Vitech-UA/Freq-invertor-MC3PHAC/Фото. Фільтр для частотника.jpg

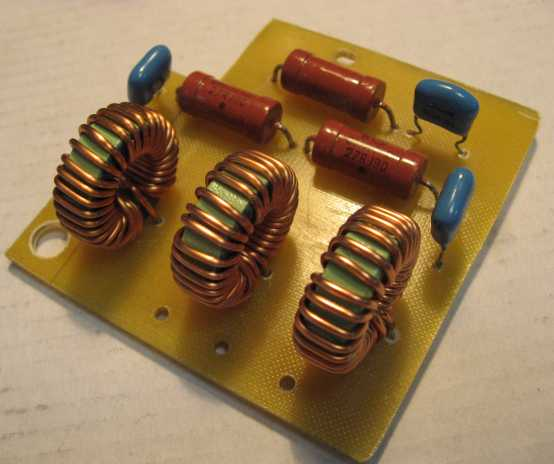
Фото. Фільтр для частотника.jpg
