Vitech-UA/Freq-invertor-MC3PHAC/README.md

# Зібраний екземпляр
