Vitech-UA/Freq-invertor-MC3PHAC/Робочий варіант/Тормозной модуль.pdf

Тормозной модуль

Контроллер MC3PHAC позволяет реализовать резистивное торможение. При превышении напряжения ЗПТ на 10% от номинального значения (при торможении двигатель начинает работать в генераторном режиме, генерируемая энергия накапливается на конденсаторе ЗПТ) контроллер будет подавать ШИМ с несущей частотой f

br ШИМ = 5 кГц на пин RBRAKE. Для реализации торможения необходимо

использовать транзистор, который будет работать в ключевом режиме и «сливать» заряд с конденсатора ЗПТ через тормозной резистор. Такая схема показана на рисунке 3.34.

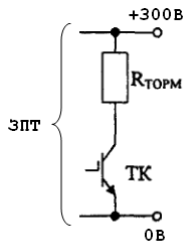
[picture p7: figure]

Рисунок 3.34 – Схема резистивного торможения

Тормозное сопротивление рассчитаем по [92], [55, с. 54], [48, с. 476].

Максимальное ускорение при торможении:

1 2
2
6000 0 | об
3000
2 | с br

n n
a
t
= | = | = | ,

где 1

n ,
2

n – частота вращения вала двигателя в начале и в конце торможения, об/мин;
br t – время торможения, с.

Такое ускорение торможения в данном случае допустимо по нормам механики двигателя и исполнительного механизма (
доп

a a ≤ ), а также может быть обеспечено

контроллером MC3PHAC (поддерживает ускорение до 127 Гц). Максимальное угловое ускорение при торможении:

max | 2
2 | 2 3,142 | рад
3000 | 314,159
60 | 60 | с
br | a

π
ε

·
= · | = | · | = | .

Динамический момент при торможении:

д M | J = Σ
·ε = 0,0061 314,159 1,916 · | = | Н ·м ,

где JΣ
– суммарный момент инерции, приведенный к валу двигателя,

2

кг ·м ; примем
2
дв
J | J Σ = 8 | 8 0,00076 0,0061 · | = · | = | кг ·м .

Максимальный тормозной момент:

max | д | с M | M | M br | = | - | =1,916 1,284 0,632 - | = | Н ·м,

где Mс
– статический рабочий момент сопротивления; примем равным номинальному моменту:
с | н M | M= | =1,284 Н ·м .

Максимальная мощность при торможении:

1
max | max
2 | 2 6000 0,632 | 397 Вт
60 | 60 br | br

n

P | M | π · | π ·
= | · | = | · | = | .

Коэффициент уменьшения для генераторного режима [55, табл. 1] выберем по таблице 2:

k = 0,25.

Таблица 2 – Таблица выбор коэффициента уменьшения мощности

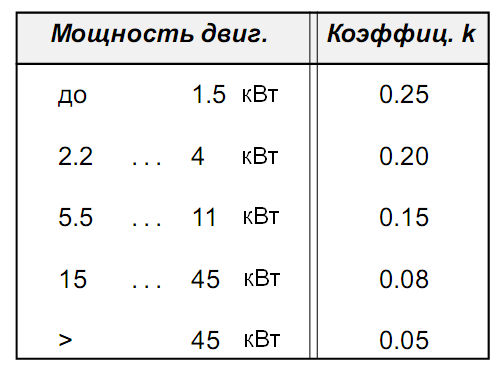
[picture p8: figure]

Электрическая мощность торможения (если < 0, значит энергия в привод не возвращается и тормозной модуль не нужен) :

электр | max | ном
397 0,25 370 305 Вт P | P | k P = br | - · | = | - | · | = | .

Омическое сопротивление тормозного модуля:

2 | 2

электр

340 379 Ом
305

br
br

U
R
P
< | = | < | ,

где Ubr – напряжение срабатывания торможения, В;
для MC3PHAC | ЗПТном U | U br =1,1 | 309 1,1 340 · | = | · = | В.

Из стандартных выбираем Rbr = 300 Ом . Тогда электрическая мощность

пересчитается:

2 | 2

электр

340 385,333 Вт
300

Ubr P
R
= | = | = | .

Время рабочего цикла 5 минут. По [55] для ц

t >120 с принимаем время

рабочего цикла:

ц

t =120 с .

Продолжительность включения тормозного модуля:

ц

2
ПВ | 100% | 100% 1,67%
120

br
br

t
t
= · | = | · | =

По графику [55, рис. 51] определяют константу к

| | | f . Этот график приведен на
рисунке 3.35.

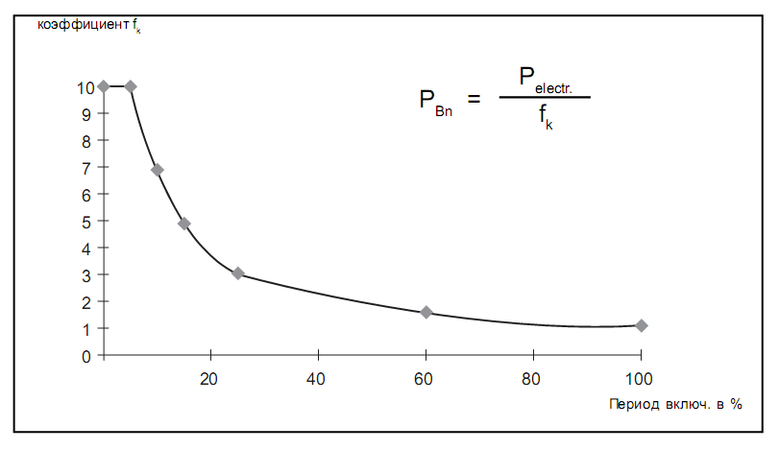
[picture p9: figure]

Рисунок 3.35 –Зависимость константы к

f от ПВ тормозного резистора

По графику на рисунке 3.35 определится константа к

f :

к

f =10.

Номинальная мощность теплового рассеяния тормозного резистора:

электр

к

385,333 38,5 Вт

10 Rbr

P
P
f
= | = | = | .

Тормозной резистор рассчитан; его сопротивление Rbr = 300 Ом , а
номинальная мощность теплового рассеяния | 38,5 Вт PRbr = | .

Стоит также заметить, что существует рекуперативное торможение с отдачей энергии торможения в сеть. Для этого применяется управляемый выпрямитель и модуль рекуперативного торможения. Но практика и расчеты показывают, что экономическая выгода таких систем торможения появляется при мощностях двигателей от 30…50 кВт.

Расчет тормозного сопротивления приведен для критических моментов торможения с довольно большой инерцией приводимого механизма. Поэтому в схеме примем резистор R77 доступной мощности 20 Вт на сопротивление 510 Ом. Схема тормозного модуля показана на рисунке 3.36.
Выберем транзистор тормозного модуля.
Ток торможения:

элект

I | P | U br | br = | = 385,333 340 1,133 = | А .

Превышение напряжение может достигать:

ЗПТкр U = 400 В.

Выберем транзистор по току и напряжению, на частоту

max | рег
f | f | u br | br = ШИМ
- 2 | 5000 2 100 1 · | = | · · | = МГц ,

где рег

u – макс. глубина регулирования; для минимальной скважности

ШИМ | ШИМmin
γ br | =1% глубина регулирования:

рег

1
100
1% 100%
u = | = | .

Таким требованиям удовлетворяет MOSFET-транзистор IRFP460.

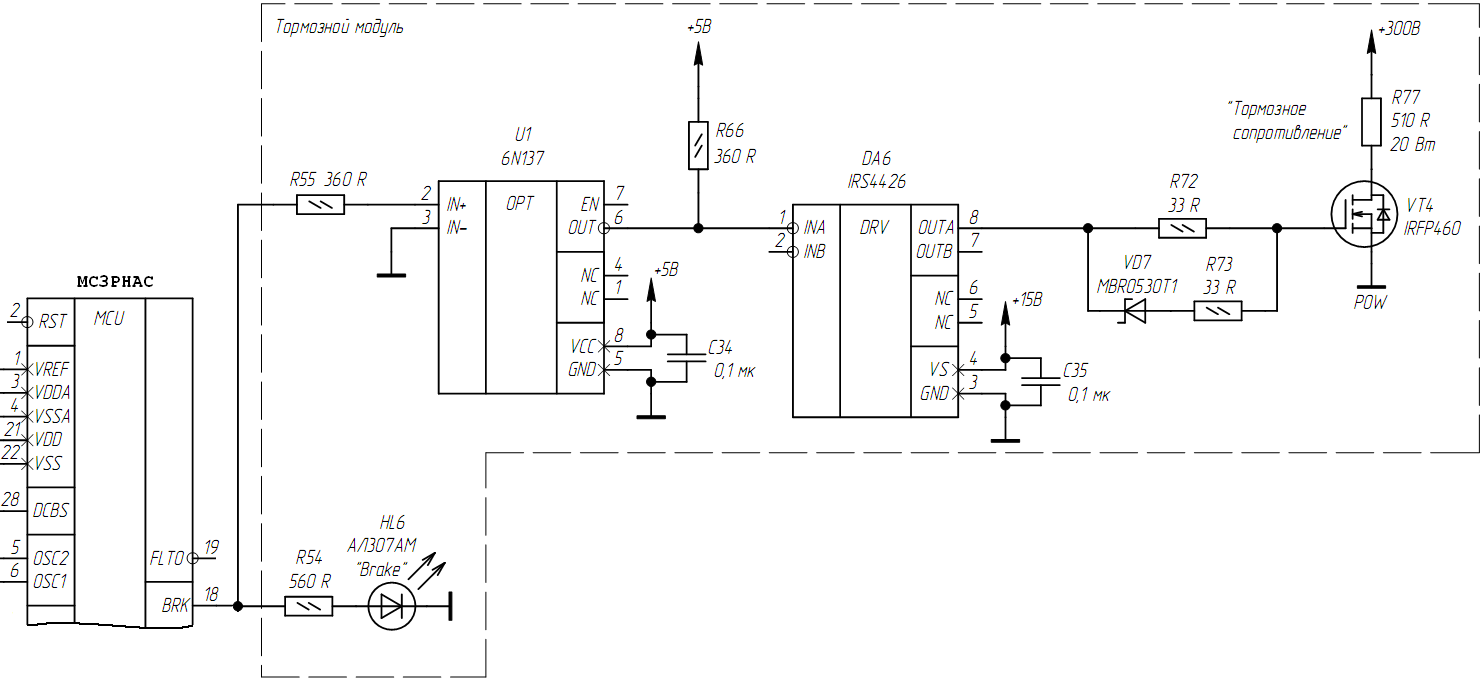
[picture p10: figure]

Рисунок 3.36 – Схема тормозного модуля

Для открытия транзистора на его затвор необходимо подать 15 В. В силу построения по КМОП-технолонии контроллер MC3PHAC работает при напряжении 5 В, соответственно амплитуда ШИМ напряжения торможения будет тоже 5 В. Для преобразования уровня напряжения применим драйвер нижних ключей IRS4426. Для быстрого закрытия транзистора в цепь затвора поставим резистор, шунтированный высокоскоростным диодом (в данном случае применен диод Шоттки MBR0530T1) – цепочка R72-VD7-R73.
Чтобы защитить пин торможения контроллера применим оптрон 6N137.
Номинальный ток передатчика-диода 6 137 I N | =10 мА . При таком токе прямое падение
напряжение составит | 6 137 ΔU N | =1,4 В. Тогда при питании от контроллера 5 В

необходим ограничивающий резистор сопротивлением

пит | 6 137
55 | 3
6 137

5 1,4 360 Ом
10 10

N

N

U U R
I

- Δ | -
= | = | =
·

Сопротивление нагрузки R66 выберем по графикам в паспорте на этот оптрон на максимальную скорость работы:

66 R = 360 Ом.

Также применена индикация торможения на светодиоде HL6. В зависимости от скважности ШИМ светодиод будет гореть с разной яркостью, по которой можно судить о процессе торможения.
