Vitech-UA/Freq-invertor-MC3PHAC/element/схема.gif

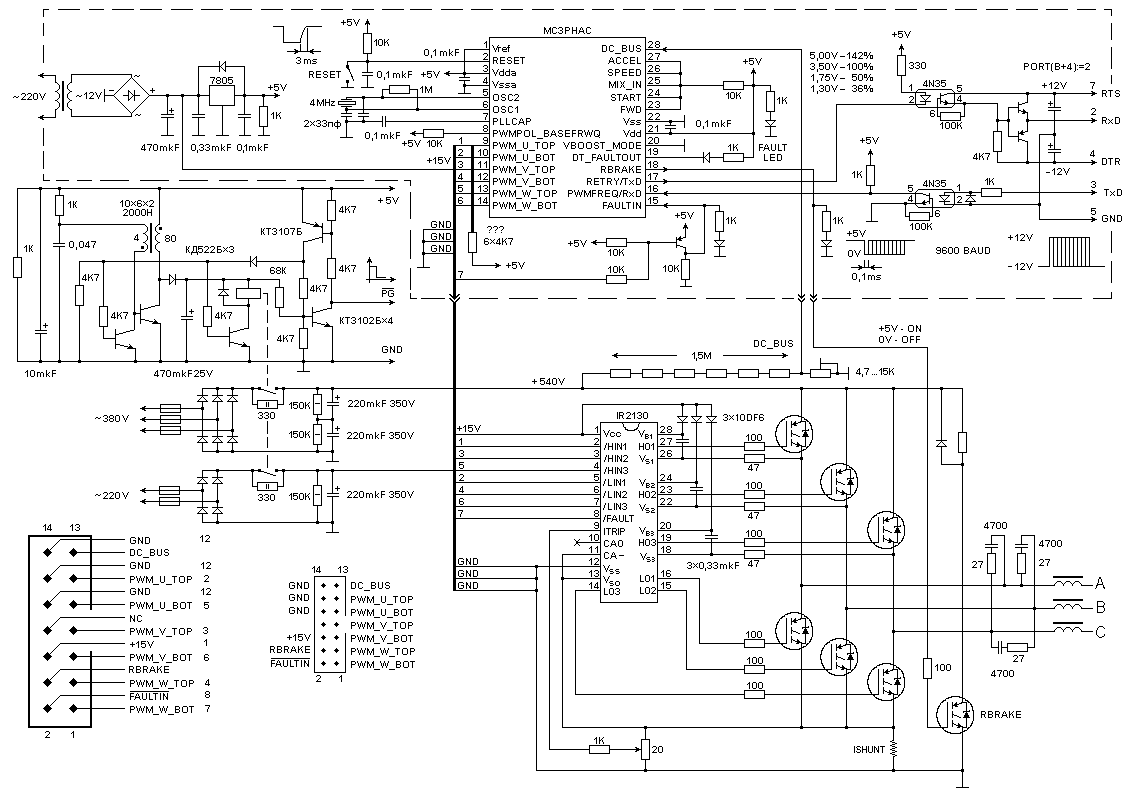
element/схема.gif
