Vitech-UA/Freq-invertor-MC3PHAC/element/ТПЧ.gif

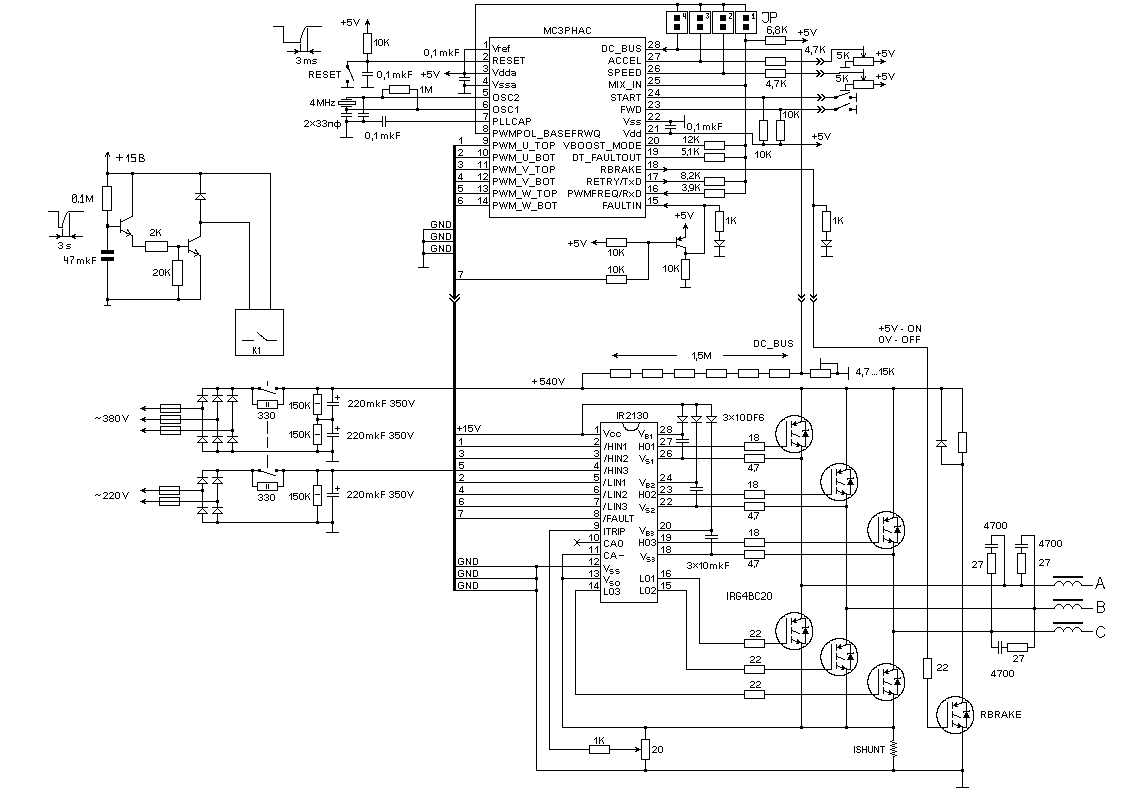
element/ТПЧ.gif
