Vitech-UA/Freq-invertor-MC3PHAC/pcb-shematic/circuit_b.gif

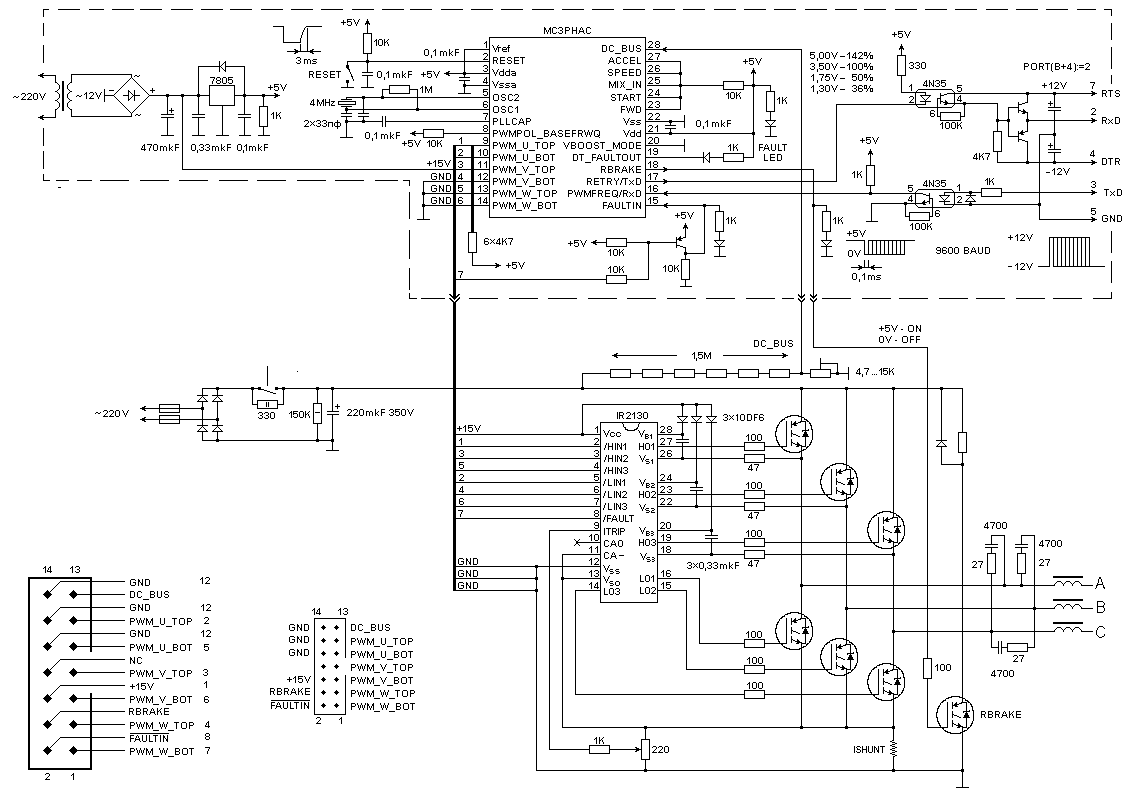
pcb-shematic/circuit_b.gif
