Vitech-UA/Freq-invertor-MC3PHAC/Версія 1/VER 2.1 plata.JPG

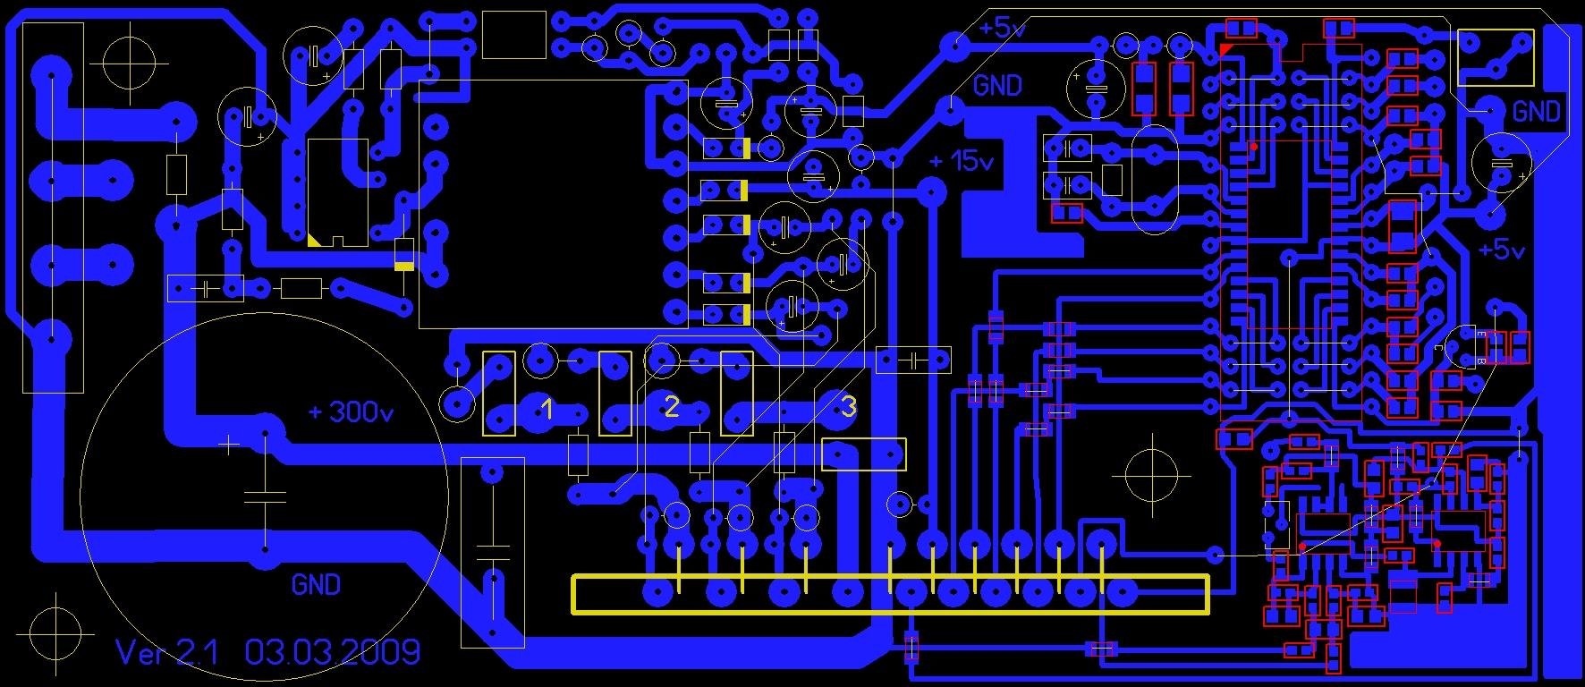
Версія 1/VER 2.1 plata.JPG
