Vitech-UA/Freq-invertor-MC3PHAC/Версія 1/VER 2.1 shema.JPG

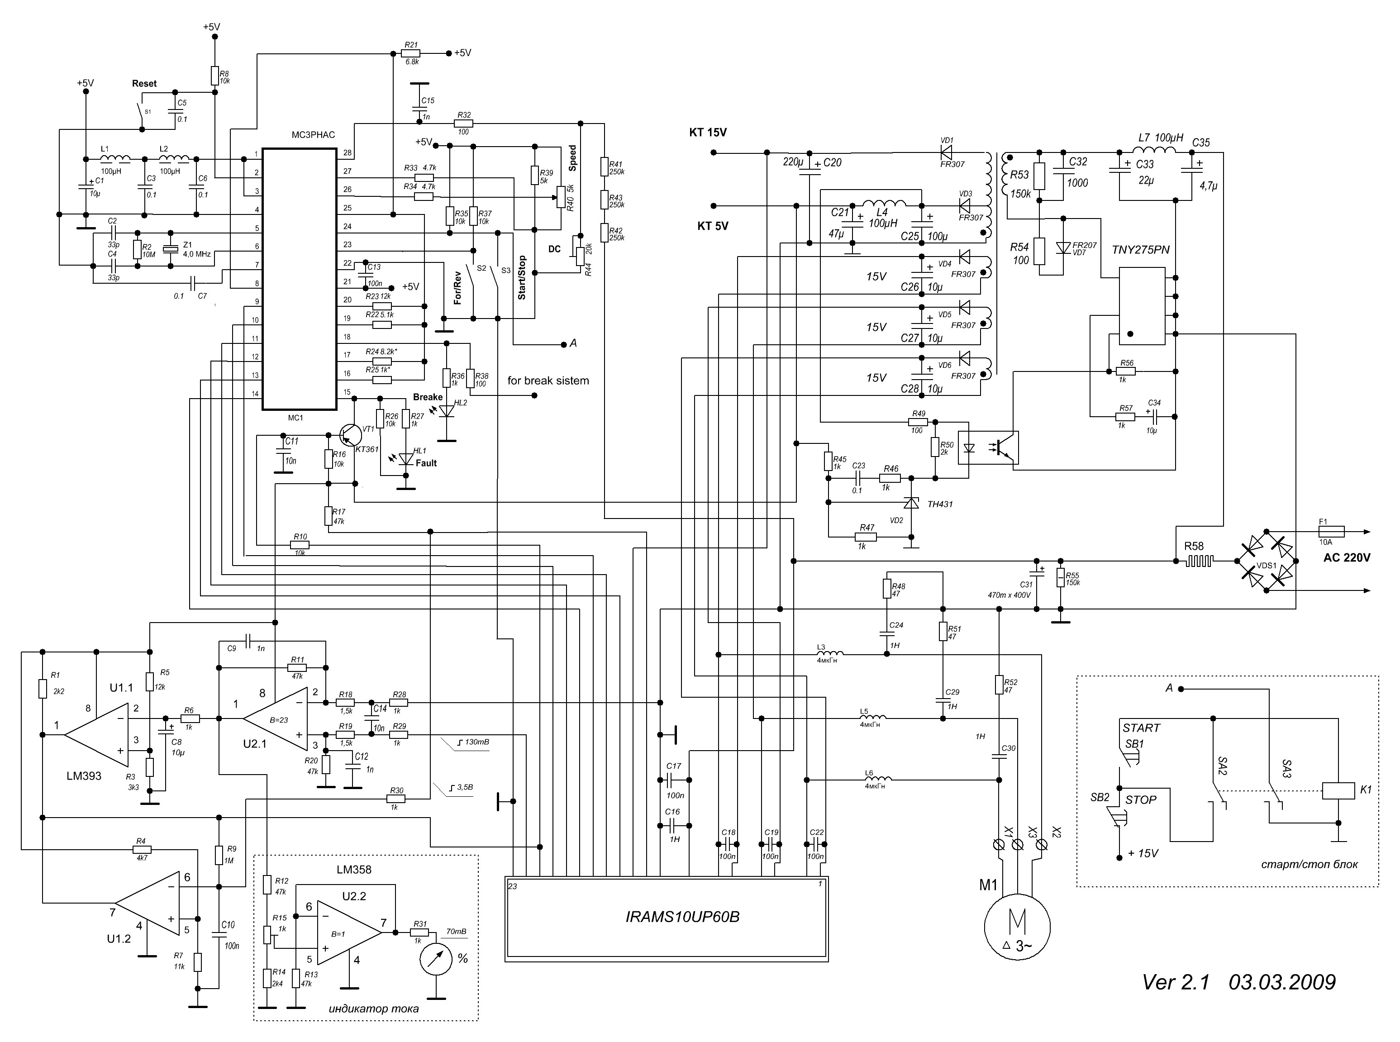
Версія 1/VER 2.1 shema.JPG
