Vitech-UA/Freq-invertor-MC3PHAC/Робочий варіант/П.З/Лист задания на д.п/02.tif

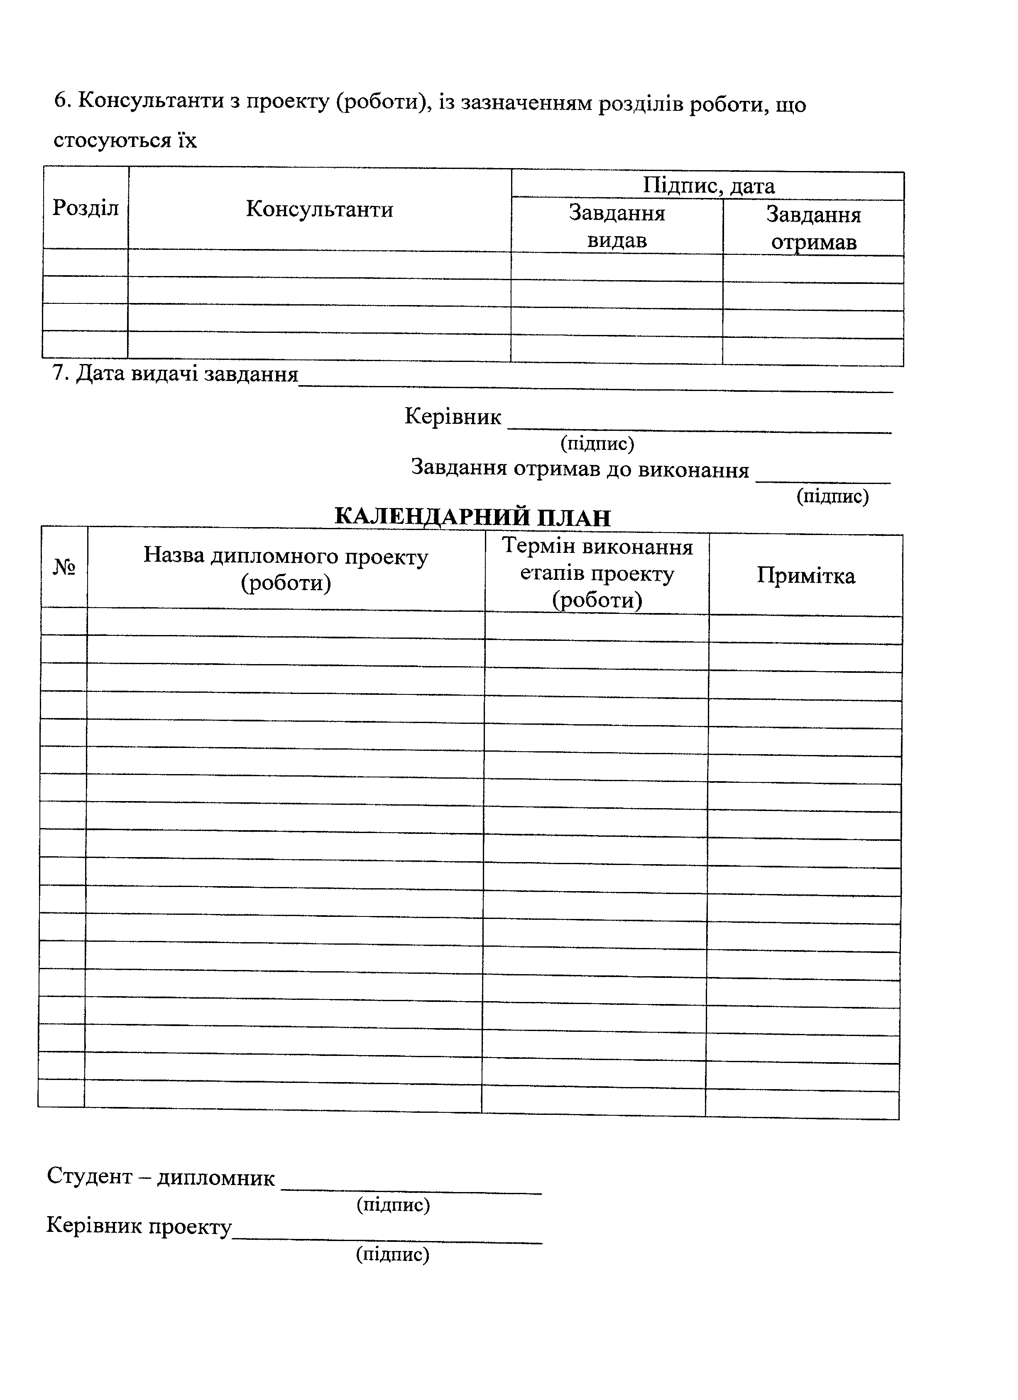
Робочий варіант/П.З/Лист задания на д.п/02.tif
