Vitech-UA/Freq-invertor-MC3PHAC/(list of files, drawings)

Other design files:
pcb-shematic/3фазний міст.dip
pcb-shematic/310В + Плавний пуск.dip
pcb-shematic/bridge.dch
pcb-shematic/Оновлений блок живлення 5-12-15-310.dip
pcb-shematic/Плата 3-фазного мосту.dip
pcb-shematic/Плата блоку живлення 310В +15В +5В.dip
pcb-shematic/Плата вихідного фільтра.dip
pcb-shematic/Плата гальмівного модуля.dip
pcb-shematic/Плата драйвера.dip
pcb-shematic/Плата керування.dip
pcb-shematic/Схема блоку живлення 310В і пл.Пуск.dch
Версія 1/Ver 2.1.lay
Гальванічна розв'язка модуля FAULT.DSN
Робочий варіант/tpch.dip
